nisalparanawithana/TIMER-Plug-Socket/PCB Design/IMG-20230223-WA0002.jpg

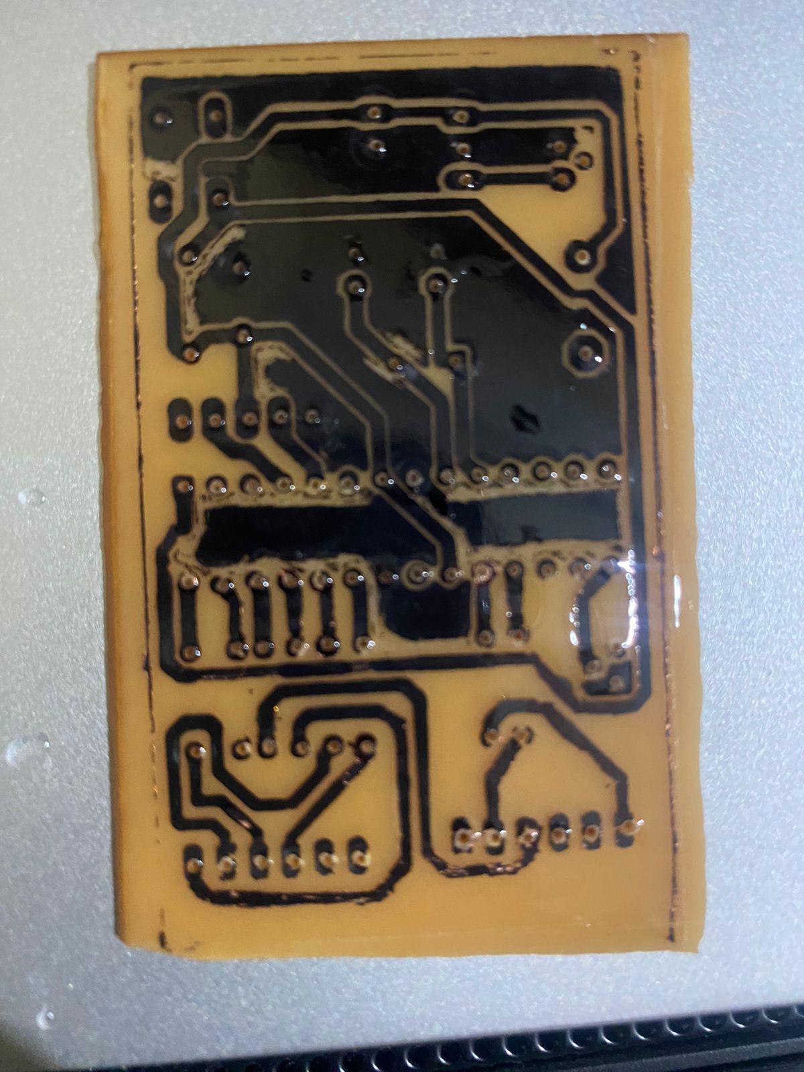
PCB Design/IMG-20230223-WA0002.jpg
