nisalparanawithana/TIMER-Plug-Socket/Box Design/side 2 (10x5cm) II.jpg

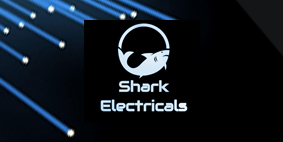
Box Design/side 2 (10x5cm) II.jpg
