nisalparanawithana/TIMER-Plug-Socket/README.md

# TIMER-Plug-Socket
This is my 3rd year group Project of Engineering Product Design.
An electirc plug socket for domestic users with a time control setting
Enable the abilty to reduce energy wastage & time wastage
Flexible to assemble with the domestic electrical installation system
