nisalparanawithana/TIMER-Plug-Socket/Box Design/side 1 (23.5x5cm) I.jpg

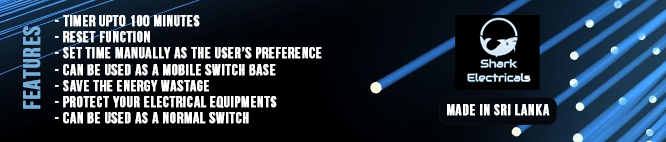
Box Design/side 1 (23.5x5cm) I.jpg
