nisalparanawithana/TIMER-Plug-Socket/Box Design/side 2 (10x5cm) I.jpg

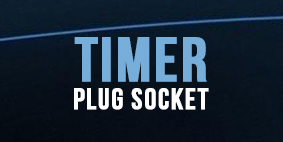
Box Design/side 2 (10x5cm) I.jpg
