nisalparanawithana/TIMER-Plug-Socket/Box Design/Top (23.5x10cm).png

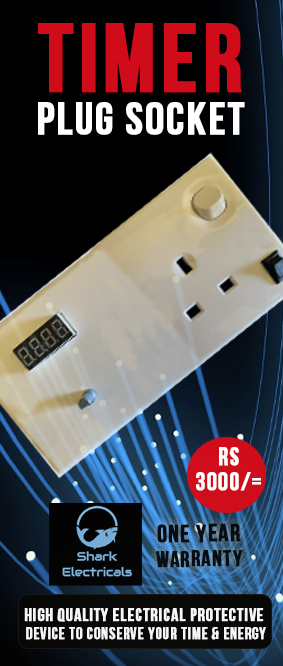
Box Design/Top (23.5x10cm).png
