nisalparanawithana/TIMER-Plug-Socket/Eagle PCB Design/Schematic1.png

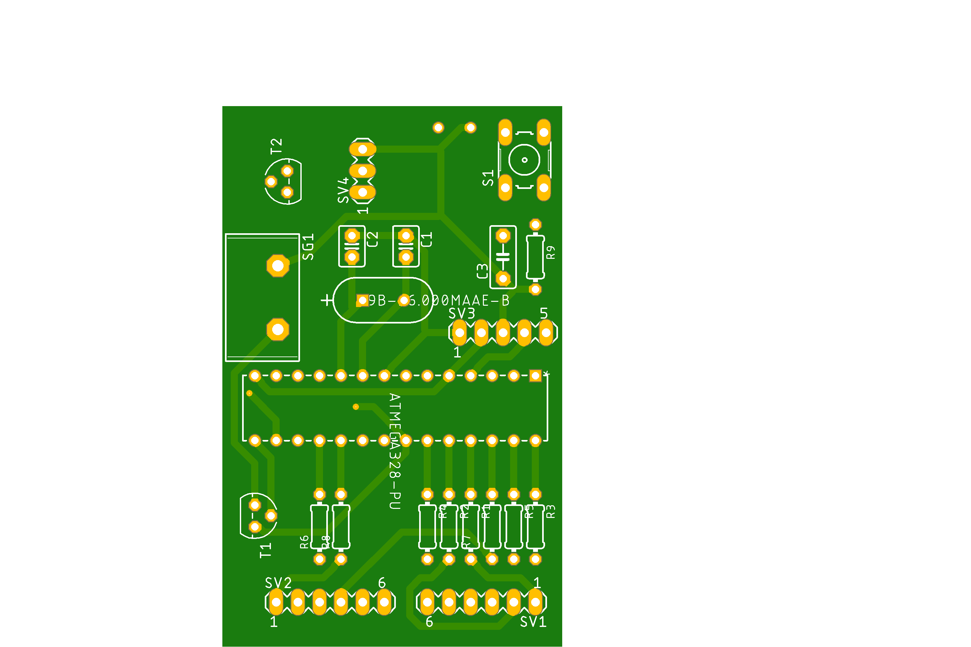
Eagle PCB Design/Schematic1.png
