nisalparanawithana/TIMER-Plug-Socket/PCB Design/IMG-20230223-WA0005.jpg

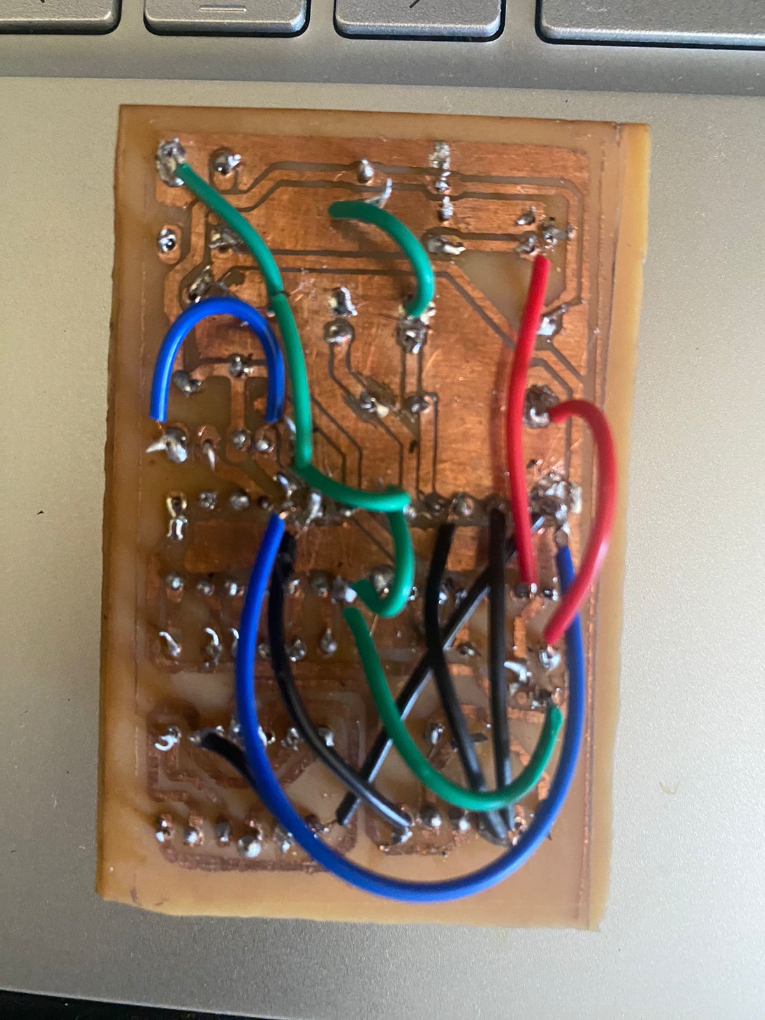
PCB Design/IMG-20230223-WA0005.jpg
