nisalparanawithana/TIMER-Plug-Socket/PCB Design/Screenshot 2023-02-20 152412.jpg

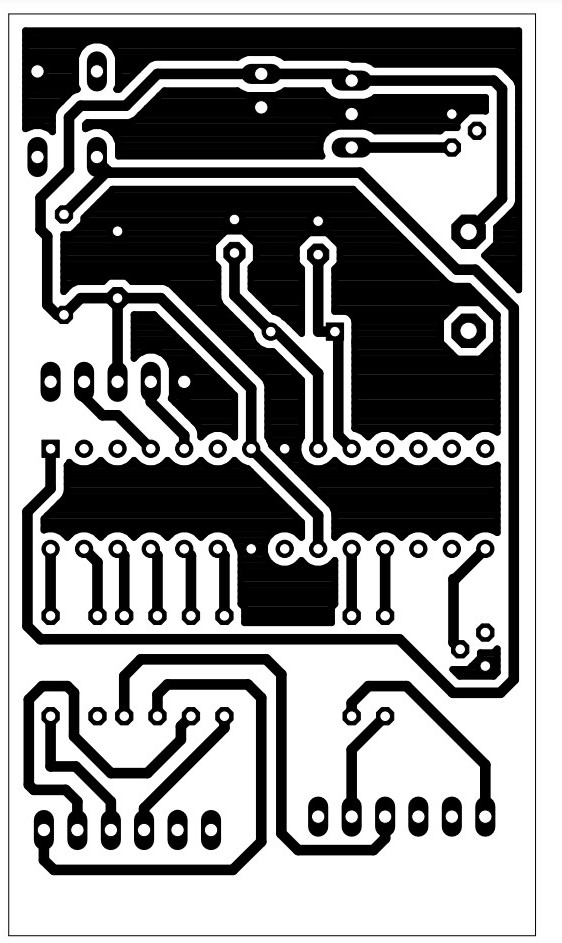
PCB Design/Screenshot 2023-02-20 152412.jpg
