nisalparanawithana/TIMER-Plug-Socket/RelayTimerCode/diagram timer.png

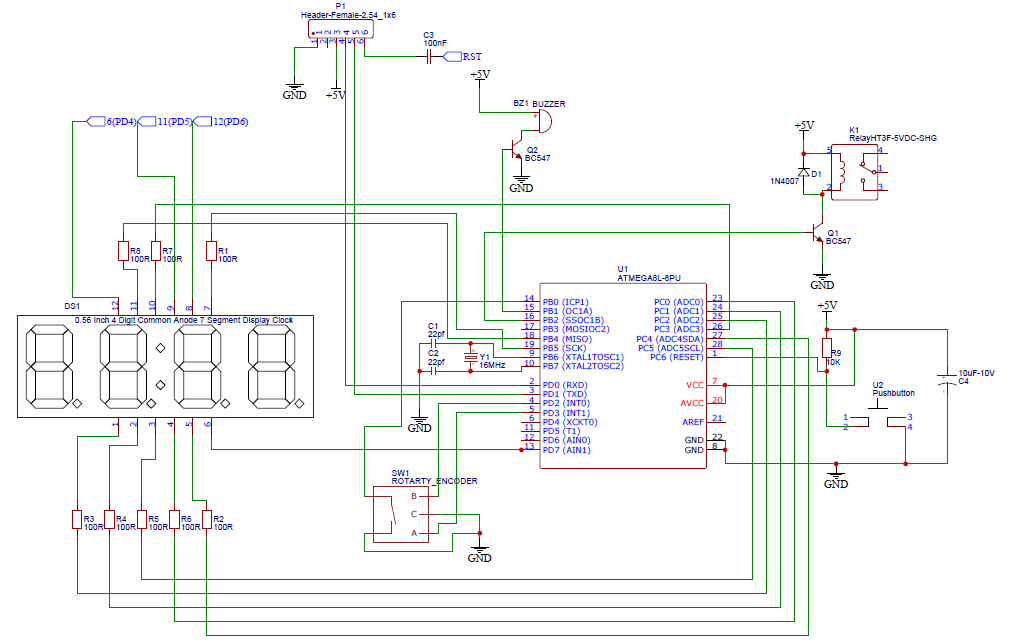
RelayTimerCode/diagram timer.png
