nisalparanawithana/TIMER-Plug-Socket/Eagle PCB Design/Schematic1_BottomLayer.pdf

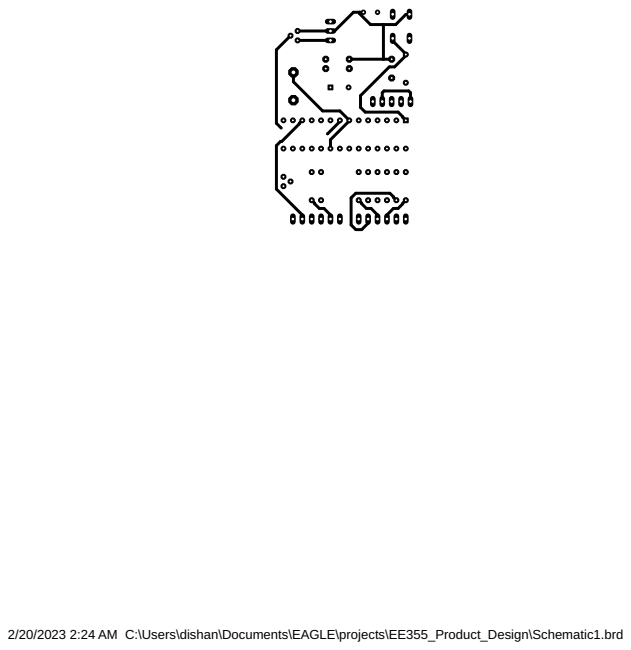
[picture p33: page 1]

2/20/2023 2:24 AM C:\Users\dishan\Documents\EAGLE\projects\EE355_Product_Design\Schematic1.brd
