nisalparanawithana/TIMER-Plug-Socket/Eagle PCB Design/Schematic1_TopLayer.pdf

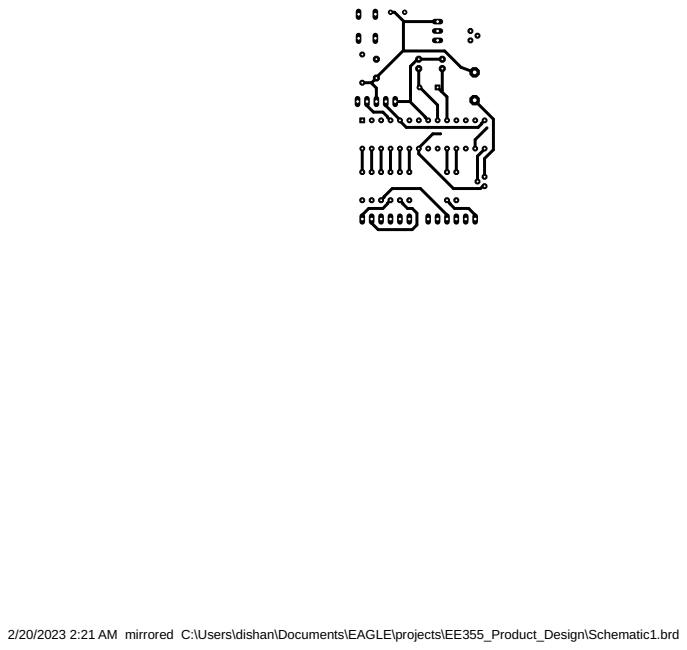
[picture p34: page 1]

2/20/2023 2:21 AM mirrored C:\Users\dishan\Documents\EAGLE\projects\EE355_Product_Design\Schematic1.brd
