nisalparanawithana/TIMER-Plug-Socket/Eagle PCB Design/NEW.pdf

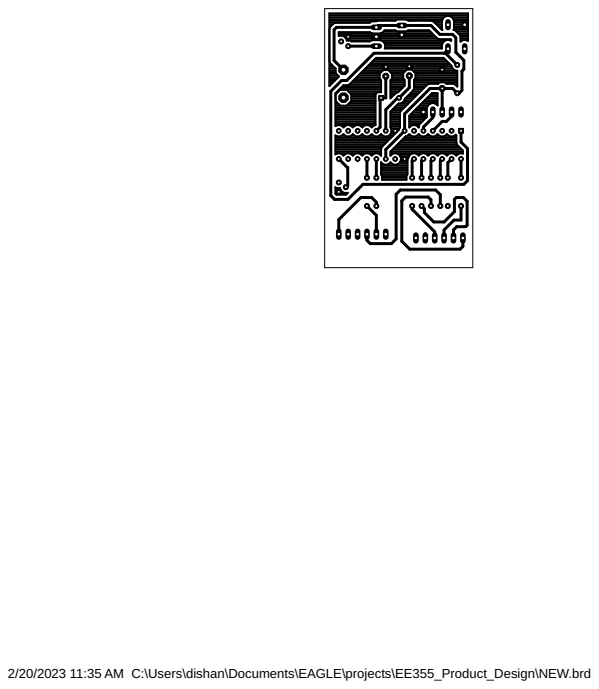
[picture p35: page 1]

2/20/2023 11:35 AM C:\Users\dishan\Documents\EAGLE\projects\EE355_Product_Design\NEW.brd
