nisalparanawithana/TIMER-Plug-Socket/Eagle PCB Design/NEW (2).pdf

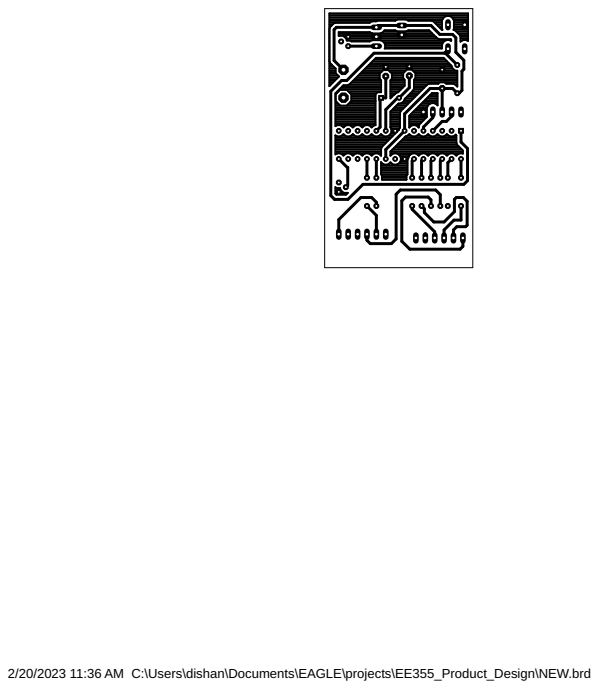
[picture p36: page 1]

2/20/2023 11:36 AM C:\Users\dishan\Documents\EAGLE\projects\EE355_Product_Design\NEW.brd
