nisalparanawithana/TIMER-Plug-Socket/Eagle PCB Design/Schematic1.brd

## EAGLE design Eagle PCB Design/Schematic1.brd (2023-10-14)

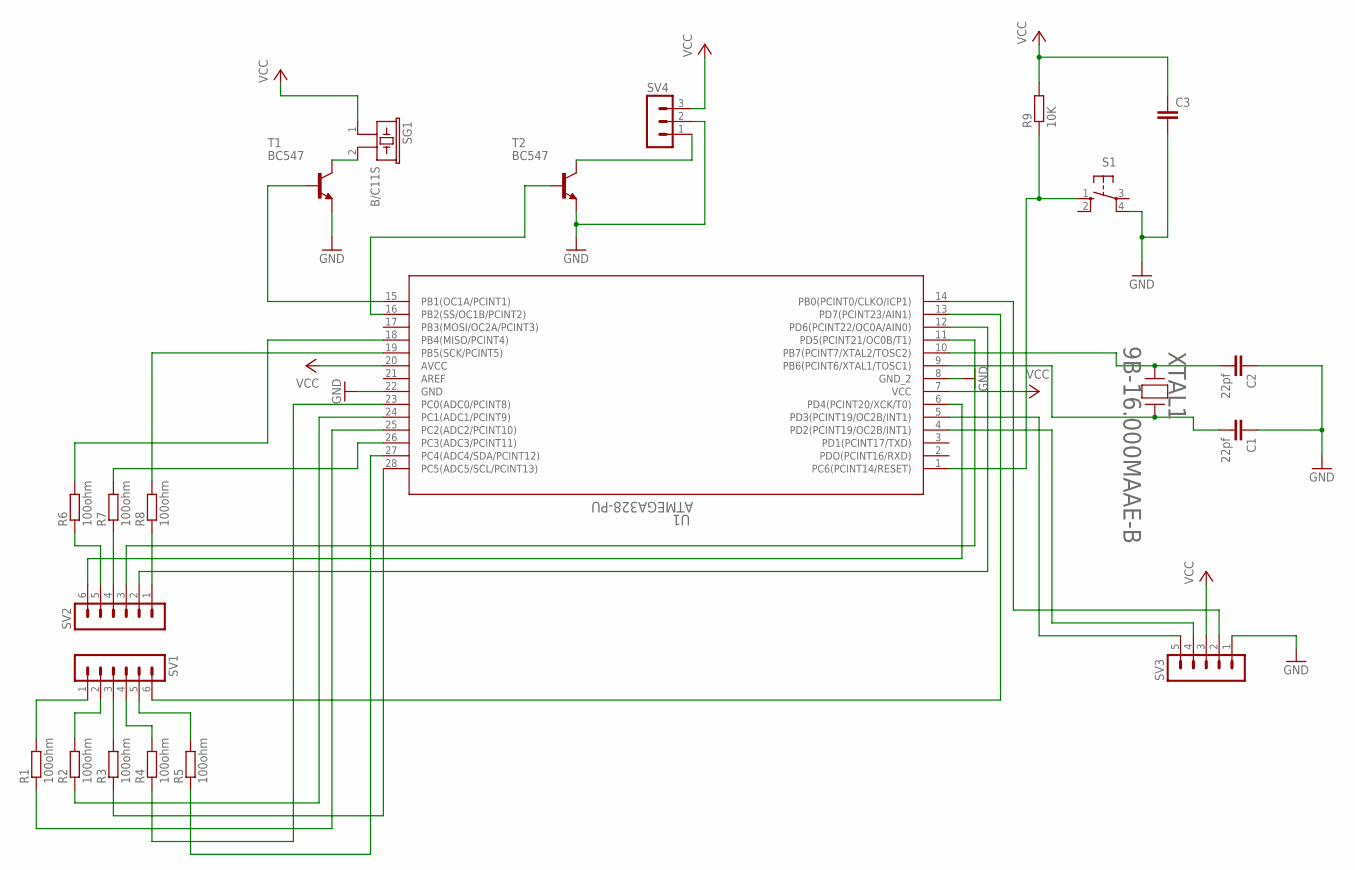
[picture p37: schematic Schematic1.sch]

Parts:
C1, C2: 22pf; C2.5-3
C3: C5/3; C5B3
R1, R2, R3, R4, R5, R6, R7, R8: 100ohm; 0204/7
R9: 10K; 0204/7
S1: 10-XX; B3F-10XX
SG1: B/C11S
SV1, SV2: MA06-1
SV3: MA05-1
SV4: MA03-1
T1, T2: BC547; TO92
U1: ATMEGA328-PU; 28P3_SPDIP28_SP_MCH
XTAL1: 9B-16.000MAAE-B; 9B-16.000MAAE-B_TXC

Connections:
GND: C1.1, C2.1, C3.2, S1.4 (P1), SV3.1, SV4.2, T1.1 (E), T2.1 (E), U1.8 (GND_2), U1.22 (GND)
unnamed: R1.2, SV1.1
unnamed: R1.1, U1.25 (PC2(ADC2/PCINT10))
unnamed: R2.2, SV1.2
unnamed: R3.2, SV1.3
unnamed: R4.2, SV1.4
unnamed: R2.1, U1.24 (PC1(ADC1/PCINT9))
unnamed: SV1.6, U1.13 (PD7(PCINT23/AIN1))
unnamed: R4.1, U1.23 (PC0(ADC0/PCINT8))
unnamed: R5.2, SV1.5
unnamed: R5.1, U1.27 (PC4(ADC4/SDA/PCINT12))
unnamed: R8.1, SV2.1
unnamed: R8.2, U1.19 (PB5(SCK/PCINT5))
unnamed: SV2.2, U1.12 (PD6(PCINT22/OC0A/AIN0))
unnamed: SV2.3, U1.11 (PD5(PCINT21/OC0B/T1))
unnamed: R7.1, SV2.4
unnamed: R7.2, U1.26 (PC3(ADC3/PCINT11))
unnamed: R6.1, SV2.5
unnamed: R6.2, U1.18 (PB4(MISO/PCINT4))
unnamed: SV2.6, U1.6 (PD4(PCINT20/XCK/T0))
unnamed: C1.2, U1.9 (PB6(PCINT6/XTAL1/TOSC1)), XTAL1.2
unnamed: C2.2, U1.10 (PB7(PCINT7/XTAL2/TOSC2)), XTAL1.1
unnamed: T1.2 (B), U1.15 (PB1(OC1A/PCINT1))
unnamed: SV3.2, SV3.5, U1.5 (PD3(PCINT19/OC2B/INT1)), U1.14 (PB0(PCINT0/CLKO/ICP1))
unnamed: SV3.4, U1.4 (PD2(PCINT19/OC2B/INT1))
unnamed: SG1.2, T1.3 (C)
unnamed: T2.2 (B), U1.16 (PB2(SS/OC1B/PCINT2))
unnamed: SV4.1, T2.3 (C)
unnamed: R9.1, S1.1 (S), U1.1 (PC6(PCINT14/RESET))
VCC: C3.1, R9.2, SG1.1, SV3.3, SV4.3, U1.7 (VCC), U1.20 (AVCC)

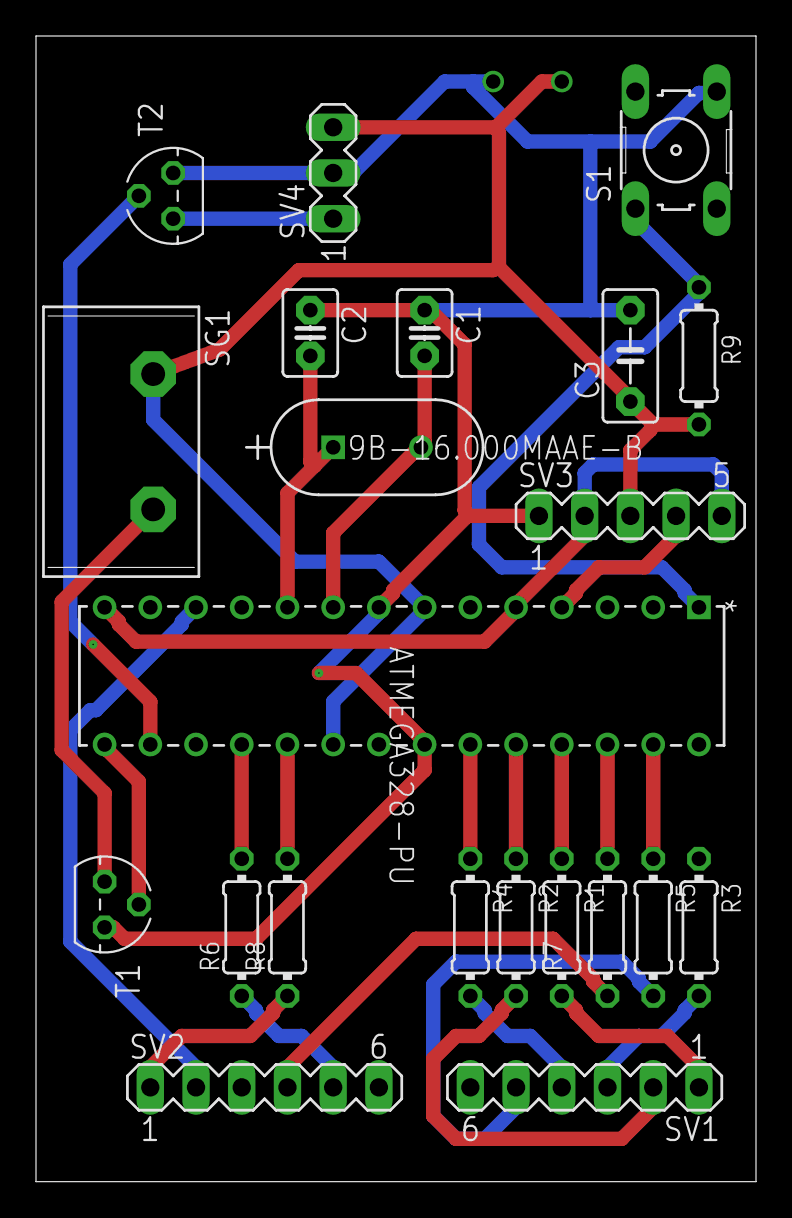
[picture p38: board Schematic1.brd from above]

Board: 2 copper layers, 40.0 x 63.6 mm, 22 parts (0 on the bottom side), 30 nets.
