nisalparanawithana/TIMER-Plug-Socket/(notices)

Notices in the files:
parts and their libraries:
ATMEGA328PU: COPYRIGHT: Copyright (C) 2023 Ultra Librarian. All rights reserved.
